nicholasbirochi/Standalone-Fingerprint-Key/docs/img/exploded.png

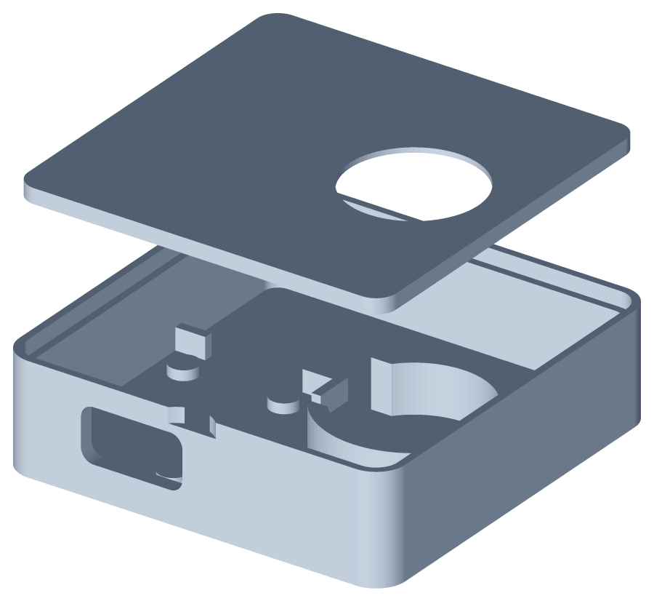
docs/img/exploded.png
