nicholasbirochi/Standalone-Fingerprint-Key/docs/img/variants.png

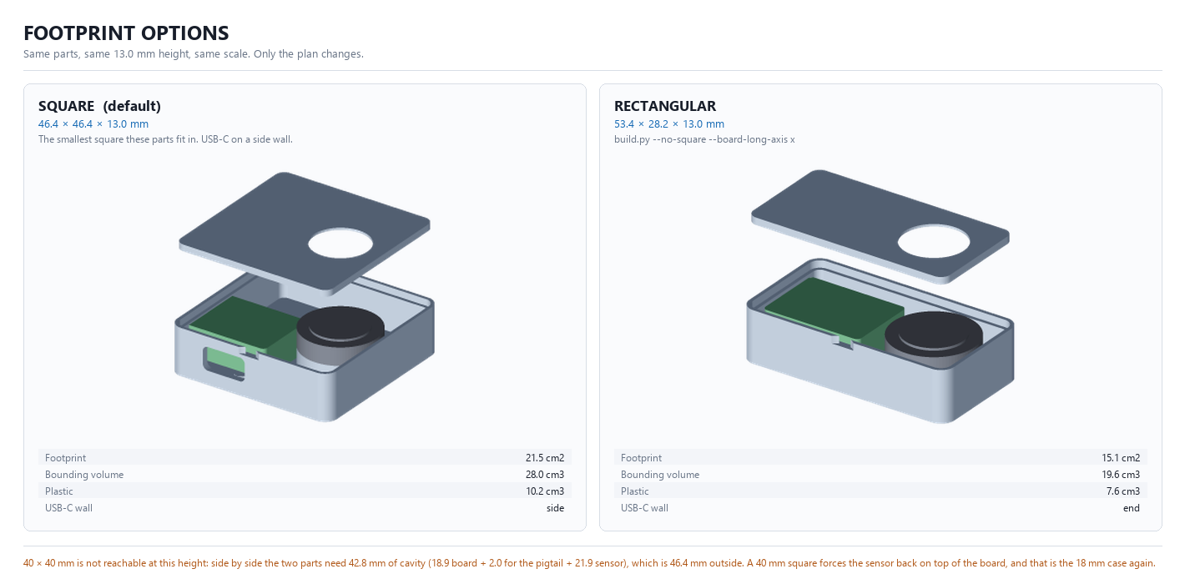
docs/img/variants.png
