nicholasbirochi/Standalone-Fingerprint-Key/enclosure/stl/lid.stl

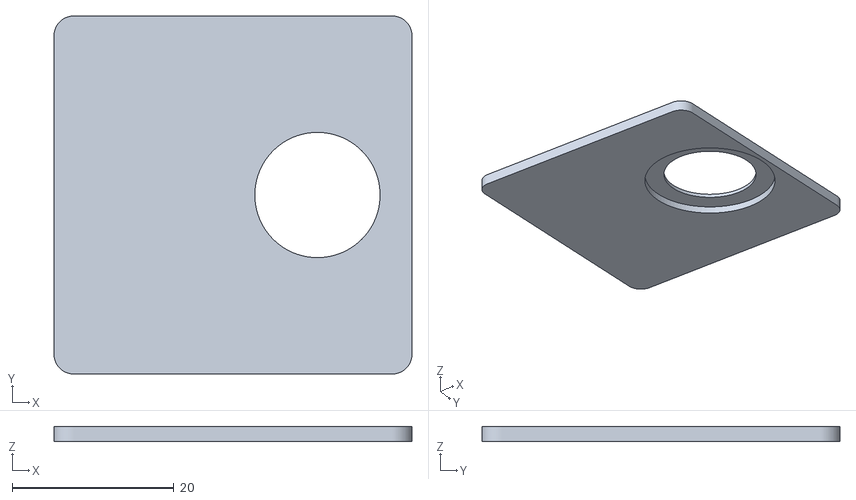
[picture p3: CAD file, 2026-09-23]
enclosure/stl/lid.stl
44.3 x 44.3 x 1.80
