nicholasbirochi/Standalone-Fingerprint-Key/(commit log)

2026-09-23 chore: Add gitignore and line-ending normalisation
    The supplied enclosure zips stay out of the repository: they are
    generated STLs from an earlier revision, superseded by enclosure/.
2026-09-23 chore(enclosure): record the measured component dimensions
    ESP32-S3 25 x 18 x 8 mm with two USB-C connectors on one short edge,
    HLK-ZW111 body 21 x 5 mm with a 15 mm reading face standing 0.6 mm
    proud. These are measurements, not datasheet guesses, and every other
    dimension in the enclosure is derived from them.
    Keys beginning with an underscore are documentation and are stripped
    before the model reads the file, so there are no dead parameters.
2026-09-23 chore(enclosure): add the parametric shell model
    Side-by-side layout rather than stacking the sensor on the board. The
    obvious arrangement adds the two tallest parts together and then needs
    screw bosses to hold a deep lid on; laying them out side by side makes
    the height whichever single column is tallest and turns the lid into a
    flat plate.
    Built with a CSG kernel that only emits manifold solids, so anything it
    writes is watertight by construction. The pieces that are easy to get
    subtly wrong are commented where they are:
    - The sensor seat matches the module body, not the pocket, so it never
    lands tangent to the cavity wall. A tangent surface is both a weak
    print and a non-manifold ed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
2026-09-23 chore(enclosure): add the build script and its dimension checks
    Prints where every millimetre of the height goes, then refuses to leave
    quietly if a check fails. The checks are about the design being sensible
    rather than the mesh being valid, since the kernel already guarantees the
    latter: does the retaining lip still clear the reading face, does the seat
    leave room for the pigtail, does the USB opening stay inside the wall.
    --no-square and --board-long-axis build the rectangular layout without
    editing params.json, which keeps both variants honest.
2026-09-23 chore(enclosure): export the printable parts
    46.4 x 46.4 x 13.0 mm, two parts, no divider and no screws. Committed so
    that printing needs a slicer and nothing else.
    Both meshes verified watertight, manifold and consistently wound. That is
    a statement about the geometry, not about fit.
2026-09-23 chore(tools): add the isometric renderer
    numpy and the standard library only -- no Pillow, no headless GL. Meshes
    are projected isometrically, back faces culled, the rest rasterised with a
    z-buffer at 3x and box-filtered down. Backgrounds stay transparent so the
    images read correctly in both GitHub themes.
    The view keeps its own projection so that annotations can later be placed
    on real geometry rather than guessed at in pixels.
2026-09-23 chore(tools): render the shell with the components in place
    The stand-ins are the measured envelopes positioned by the same layout the
    shell is built from, so a part that does not meet the surface it should
    shows up here rather than in PLA. Which is exactly what happened: this is
    what caught the sensor sitting 1.2 mm below the lid's counterbore.
2026-09-23 chore(tools): add the one-page technical sheet
    Assembled, exploded, orthographic and section views, plus the height
    budget, the bill of materials and the print settings.
    Every view is a render of the model the STLs come from and every dimension
    line is projected through that view's own camera, so the numbers on the
    drawing cannot drift away from the geometry. Change params.json, run this,
    and the sheet is correct again.
2026-09-23 chore(tools): compare the footprint options side by side
    Same parts, same height, same scale. The only honest way to choose between
    a square puck and a rectangular stick is to see both with their volumes
    underneath.
2026-09-23 chore(firmware): add ZW111 packet framing
    The 0xEF01 protocol shared by the ZhianTec / Synochip family. Kept free of
    any Arduino dependency so the framing can be tested on a host, where a
    wrong checksum is cheap to find instead of presenting as a silent timeout.
    Two details in this protocol cause most of the wasted time: the length
    field counts the checksum bytes, and the checksum covers the length field
    itself.
    The parser is a byte-at-a-time state machine rather than a blocking read.
    It resynchronises after garbage, does not false-start on a run of 0xEF, and
    bounds the declared length before trusting it -- that field comes off the
    wire, and a frame claiming 65533 bytes of payload must be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
2026-09-23 chore(firmware): add host-side tests for the framing
    Eleven tests, no board attached. They cover the datasheet's own example
    frame byte for byte, the length arithmetic, resynchronisation after
    garbage, and the over-long length that must be refused rather than
    buffered.
    All of these fail silently in hardware, which is the reason to catch them
    here.
2026-09-23 chore(firmware): add build and pin configuration
    ARDUINO_USB_MODE=0 selects the TinyUSB stack. With the default the S3
    exposes only the hardware CDC and the keyboard silently does nothing,
    which is a long afternoon if you do not know to look for it.
    Everything tunable lives in config.h: pins, match threshold, keystroke
    pacing, the cooldown that stops a resting finger typing the secret
    repeatedly, and the brute-force brake.
2026-09-23 chore(firmware): add the sensor driver
    Transport and command sequences over the framing library. Identify is one
    capture-and-search cycle that returns quickly when there is no finger, so
    it is safe to call from the main loop.
    Enrolment waits for the finger to lift between captures. Without that the
    next GetImage returns the same impression and the merged template is no
    better than a single capture.
    Deadlines are computed as signed differences so they survive the millis()
    rollover.
2026-09-23 chore(firmware): add the secret store
    NVS-backed, and deliberately write-only: nothing in this firmware can read
    the secret back out over the serial port.
    That is not the same as being safe, so the store knows whether the chip's
    flash encryption is on and says so. Without it NVS is plaintext and two
    minutes with esptool recovers the secret. kRequireFlashEncryption makes
    the firmware refuse to store anything until the eFuse is burned.
    A freshly flashed device holds no secret and types nothing.
2026-09-23 chore(firmware): add the USB HID typer
    To the host this is an ordinary keyboard, which is the whole trick: no
    driver, no daemon, no kernel extension. It is also the whole limitation.
    Readiness is tracked from USB events rather than guessed, since typing
    before the host has configured the interface goes nowhere. The wake tap is
    a modifier rather than a character so it inserts nothing if the machine was
    already awake, and keystrokes are paced because the login window drops
    characters that arrive faster than it redraws.
2026-09-23 chore(firmware): add status LED feedback
    Non-blocking, because the loop also has to stay responsive to the sensor.
    Brightness is capped hard -- the on-board LED is painfully bright at full
    scale in a dark room.
2026-09-23 chore(firmware): add the admin console
    How a finger gets enrolled and how the secret gets set, over the USB CDC
    port. There is no command that prints the secret back, because the cable
    carrying this console is plugged into whatever machine is nearby.
    Slot arguments are parsed and range-checked rather than passed through
    atoi, which silently turns junk into slot 0 and would cheerfully delete
    the wrong template.
    status reports how the secret is held at rest, and setting one on a chip
    without flash encryption says so in as many words.
2026-09-23 chore(firmware): add the main loop
    Animate the LED, service the console, and if neither is busy look for a
    finger. On a match, wake the host, wait for the login window to draw, then
    type.
    A touch that the image sensor cannot read is a brush past, not an attempt,
    and does not count toward the lockout. Neither do bad captures: smudges and
    partial presses are common and only real non-matches should count.
2026-09-23 chore(firmware): keep the bench sketches that proved the platform
    These are the two sketches that actually ran on the board against macOS,
    before any of this firmware existed: one proves it enumerates, the other
    proves the Mac accepts it as a keyboard. That second one is the premise of
    the entire project.
    Worth keeping rather than deleting. If the full firmware misbehaves, these
    are how you find out whether the problem is the platform or the code.
2026-09-23 chore(hardware): add wiring and the bill of materials
    Six wires. The ones that cost an evening are called out: 3.3 V and not 5 V,
    TX to RX rather than TX to TX, and a USB-C cable that actually carries
    data.
    The module does its own matching and stores its own templates, so no
    fingerprint image and no template ever crosses the UART. That is the reason
    to choose it over a bare imaging sensor.
2026-09-23 docs: add the assembly guide
    Bench first, shell second. The electronics get proven before anything goes
    into a box, and the first working prototype needs no 3D printer at all -- a
    plastic electronics box with two holes will do.
    Re-enrol once assembled. A finger enrolled on a bare module and then used
    through a bezel is presenting a different contact area.
2026-09-23 docs: add the macOS notes
    There is nothing to install, and that buys a few specific problems: the
    keyboard setup assistant on first plug-in, the US layout assumption, and
    the FileVault pre-boot screen being a different world from the login
    window.
    States plainly what it cannot do. It is not Touch ID: it cannot authorise
    sudo, unlock the Keychain or approve a settings change, and no USB keyboard
    can. It also cannot tell whether the field it just typed into was a
    password field.
    macOS still accepts a typed password, so the device stays additive -- as
    long as it is not the only thing that remembers it.
2026-09-23 docs: add the ZW111 protocol reference
    Frame layout, the commands this firmware issues, the confirmation codes you
    will actually meet, and why the parser behaves the way it does.
    Written from the protocol family's documentation. It has not been checked
    against a physical module.
2026-09-23 docs: add the threat model
    This is a USB keyboard that holds a password in flash and types it when it
    recognises a finger. Everything else follows from that sentence.
    The brief for this project said not to put the real Mac password in
    plaintext in flash, and not to build the naive 'valid finger => type a
    stored password' path. This design does not meet that, and the page says so
    rather than shipping around it: a HID device can only send keystrokes, the
    sensor exposes no key material to derive anything from, and with no
    software on the host there is no other mechanism.
    What can be fixed is the plaintext half -- flash encryption, an
    unprivileged account, nothing stored by default. None of th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
2026-09-23 docs: add the enclosure design notes
    Where the 13 mm goes, and why the first revision was 18. Run the measured
    parts through the model stacked and it reports 18.00 mm exactly, so that is
    where the millimetres were: not the lid's fault, the layout's.
    Eight of the remaining 13 mm are the ESP32-S3 module itself. Nothing in the
    enclosure beats that number -- the biggest lever left is a soldering iron
    and the pin headers.
    Also covers why 40 x 40 mm is not reachable at this height, and what
    squaring the footprint off does and does not buy.
2026-09-23 docs: add the test ledger
    What has been shown on hardware, and what has not. It is easy, when a USB
    keyboard test works, to feel like the device works; it does not.
    Demonstrated: enumeration, and typing into Notes as a keyboard.
    Not demonstrated: every single thing involving the fingerprint sensor.
    Nothing moves between the two tables without evidence.
2026-09-23 ci: build the firmware and the enclosure on every push
    Runs the protocol tests, builds the firmware, and regenerates both
    enclosure variants. build.py exits non-zero when a dimension check fails,
    so this gates params.json rather than merely re-exporting it.
    The square layout shares the model with the rectangular one, so a change
    that breaks only the variant that is not the default still fails here
    instead of waiting to be noticed.
2026-09-23 chore(firmware): do not report success when the host is not listening
    Unlock() flashed green and started the cooldown whether or not the USB
    interface was enumerated. An unenumerated host swallows every keystroke
    silently, so the device would claim to have typed a password it had not.
    Check first and show a failure instead.
    Also paint the LED on a state change rather than waiting for the next
    Tick(). Enrolment blocks for the better part of a minute without reaching
    the main loop, so the light sat on the previous colour throughout -- the
    one moment the user most needs it to say something.
2026-10-02 refactor: simplify ESP32-S3 fingerprint HID firmware
2026-10-04 docs: add Fingerprint Key prototype image
